RafNie/blackpill-ac-current-recorder/schema.png

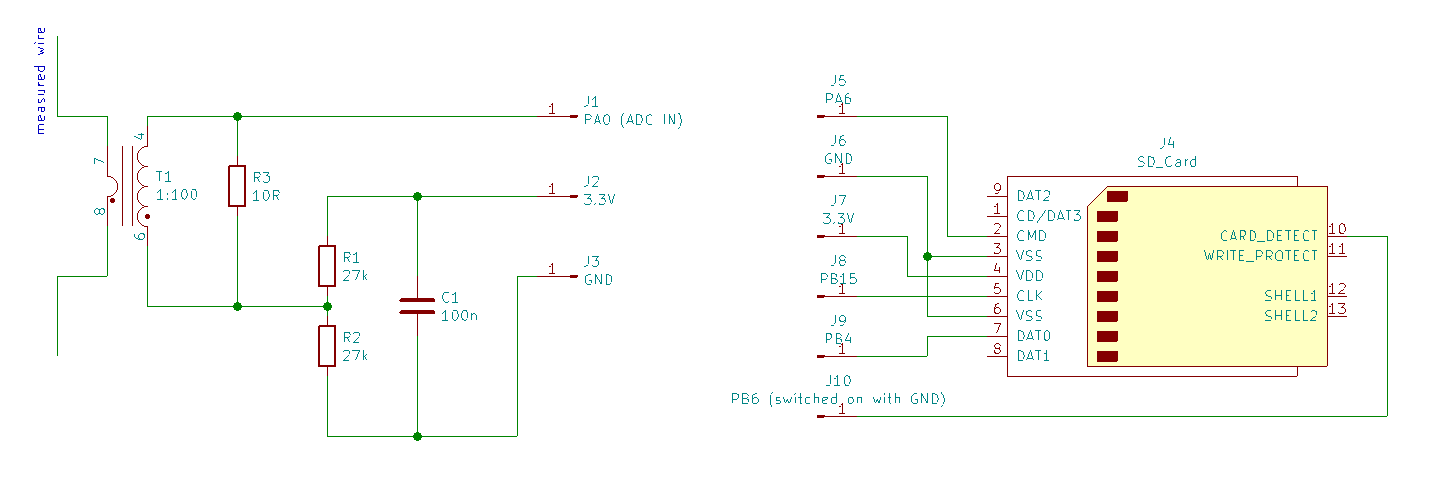
schema.png
