RafNie/blackpill-ac-current-recorder/(threads)

Thread 1 (2021-12-08):

Too long ADC conversion time

RafNie, 2021-12-08:
Minimum resistance of signal source should be around 5k7 Ohm for conversion time of current ADC configuration. This may cause processing errors or high level of noise.
The solution is decreasing values of R1 and R2 of increasing ADC conversion time.

RafNie, 2021-12-11:
The ADC prescaler was changed to 4 an the sampling time to 28.
Minimum resistance of signal source is around 58k Ohm.

https://github.com/RafNie/blackpill-ac-current-recorder/commit/e17389673ad4fe5dff25078294178d03b78dd04b

Closed 2021-12-11.

Thread 4 (2021-12-29):

ADC noise is quite high

RafNie, 2021-12-29:
The PCB the board is not best designed for analog processing, no good reference voltage and power supply for the analog section. So the adc noise is high.
As a solution the moving average filter can be replaced by more effective filter form CMSIS DSP Library.
But currently I've stopped using this data logger, so I will not implement it for now.
