RafNie/blackpill-ac-current-recorder/state_recorder/Core/Src/main.c

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

/* Includes ------------------------------------------------------------------*/
#include "main.h"
#include "fatfs.h"

/* USER CODE BEGIN Includes */
#include "input_monitor.h"
#include "event_recorder.h"
/* USER CODE END Includes */

/* USER CODE BEGIN PM */
#define ADC_BUF_SIZE 3200
#define ADC_STEPS 4095
#define ADC_REF_VOLTAGE (3.28f)
#define AVERAGE_FILTER_ORDER 16

/* USER CODE END PM */

ADC_HandleTypeDef hadc1;
DMA_HandleTypeDef hdma_adc1;

SD_HandleTypeDef hsd;
DMA_HandleTypeDef hdma_sdio_rx;
DMA_HandleTypeDef hdma_sdio_tx;

TIM_HandleTypeDef htim2;

/* USER CODE BEGIN PV */
uint32_t voltagePresent = 0;
volatile enum states currentState = stateIdle;
input_monitor inputMonitor;
event_recorder eventRecorder;

volatile uint16_t adcBuffer[ADC_BUF_SIZE] = {0};

/* USER CODE END PV */

void SystemClock_Config(void);
static void MX_GPIO_Init(void);
static void MX_DMA_Init(void);
static void MX_SDIO_SD_Init(void);
static void MX_ADC1_Init(void);
static void MX_TIM2_Init(void);
/* USER CODE BEGIN PFP */
void startEventWrapper() {
	startEvent(&eventRecorder);
}

void endEventWrapper(float averageCurrent, float energy) {
	endEvent(&eventRecorder, averageCurrent, energy);
}

static void filter(volatile uint16_t* buf, uint32_t size) {
	for (int bufIndex = 0; bufIndex<=size-AVERAGE_FILTER_ORDER; bufIndex++) {
		uint32_t sum = 0;
		for (int filerIndex = 0; filerIndex < AVERAGE_FILTER_ORDER; filerIndex++) {
			sum += buf[bufIndex+filerIndex];
		}
		sum /= AVERAGE_FILTER_ORDER;
		buf[bufIndex+AVERAGE_FILTER_ORDER-1] = sum;
	}
	for (int bufIndex = 0; bufIndex<AVERAGE_FILTER_ORDER-1; bufIndex++) {
		buf[bufIndex] = buf[AVERAGE_FILTER_ORDER];
	}
}

static uint16_t findMinMaxDiff(volatile uint16_t* buf, uint32_t size) {
	uint16_t min = *buf, max = *buf;
	if (size > 0) {
		for (int i=1; i<size; i++) {
			if (buf[i] > max) max = buf[i];
			if (buf[i] < min) min = buf[i];
		}
	}
	return max-min;
}

static inline float voltageStepsToReal(uint16_t adc_voltage) {
	return (adc_voltage*ADC_REF_VOLTAGE)/ADC_STEPS;
}

/* USER CODE END PFP */

/**
  * @brief  The application entry point.
  * @retval int
  */
int main(void)
{
  /* MCU Configuration--------------------------------------------------------*/

  /* Reset of all peripherals, Initializes the Flash interface and the Systick. */
  HAL_Init();

  /* Configure the system clock */
  SystemClock_Config();

  /* Initialize all configured peripherals */
  MX_GPIO_Init();
  MX_DMA_Init();
  MX_SDIO_SD_Init();
  MX_FATFS_Init();
  MX_ADC1_Init();
  MX_TIM2_Init();
  /* USER CODE BEGIN 2 */

  HAL_GPIO_WritePin(led_pin_GPIO_Port, led_pin_Pin, GPIO_PIN_SET);
  HAL_TIM_IC_Start_IT(&htim2, TIM_CHANNEL_1);

  inputMonitor.on_detected_event = startEventWrapper;
  inputMonitor.off_detected_event = endEventWrapper;

  HAL_Delay(10);
  initRecorder(&eventRecorder, "zasilanie");

  /* USER CODE END 2 */

  /* Infinite loop */
  /* USER CODE BEGIN WHILE */
  uint16_t Vpp = 0;

  while (1)
  {

    /* USER CODE END WHILE */

    /* USER CODE BEGIN 3 */

	  switch (currentState) {
	  case stateStartAdc:
		  HAL_ADC_Start_DMA(&hadc1, adcBuffer, ADC_BUF_SIZE);
		  currentState = stateIdle;
		  break;
	  case stateProcessInput:
		  filter(adcBuffer, ADC_BUF_SIZE);
		  Vpp = findMinMaxDiff(adcBuffer, ADC_BUF_SIZE);
		  countInput(&inputMonitor, voltageStepsToReal(Vpp));
		  currentState = stateIdle;
		  break;
	  case stateIdle: break;
	  }

  }
  /* USER CODE END 3 */
}

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
/* USER CODE BEGIN 4 */

void HAL_ADC_ConvCpltCallback(ADC_HandleTypeDef* hadc) {
	HAL_ADC_Stop_DMA(&hadc1);
	currentState = stateProcessInput;
}
/* USER CODE END 4 */
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
