RafNie/blackpill-ac-current-recorder/state_recorder/state_recorder.ioc

Mcu.UserName=STM32F411CEUx
PA0-WKUP.Signal=ADCx_IN0
PA13.Signal=SYS_JTMS-SWDIO
PA14.Signal=SYS_JTCK-SWCLK
PA6.Signal=SDIO_CMD
PB15.Signal=SDIO_CK
PB4.Signal=SDIO_D0
PB6.Signal=GPIO_Input
PC13-ANTI_TAMP.GPIO_Label=led_pin
PC13-ANTI_TAMP.Signal=GPIO_Output
