RafNie/blackpill-ac-current-recorder/(commit log)

2021-12-11 ADC fix
2021-12-29 The root of two separated from the currentTransformerRatio for more transparent RMS calculation
